mini-maglev/electrical/LTspice/motor-phase.asc

L1: ind; 0.008
R1: res; 3
V1: voltage; PWL file=pwm_sine_wave.txt
Named nets: 0
.tran 0 0.1 0 0.000001
