mini-maglev/electrical/LTspice/driver-inverter-motor.asc

AMP1_pwm_rejection: UniversalOpAmp
AMP2_pwm_rejection: UniversalOpAmp
AMP3_cheap: UniversalOpAmp
CURRENT_SENSE_AMPLIFIER_SUPPLY_?: voltage
INVERTER_SUPPLY: voltage
M1: nmos
M2: nmos
M3: nmos
M4: nmos
M5: nmos
M6: nmos
MCU_SUPPLY: voltage
R1: res
R1_small_gate_resistor_?: res
R2: res
R2_small_gate_resistor_?: res
R3: res
R4: res
R_SENSE_A1: res
R_SENSE_A: res
R_SENSE_LOW_SIDE: res
Named nets: PHASE_A_HIGH, PHASE_A_LOW, STATOR_PHASE_A, 0, PHASE_B_HIGH, PHASE_B_LOW, STATOR_PHASE_B, PHASE_C_HIGH, PHASE_C_LOW, STATOR_PHASE_C
