mini-maglev/electrical/motor_driver/motor_driver.kicad_pcb

## KiCad design motor_driver/motor_driver.kicad_pcb (2025-03-02)

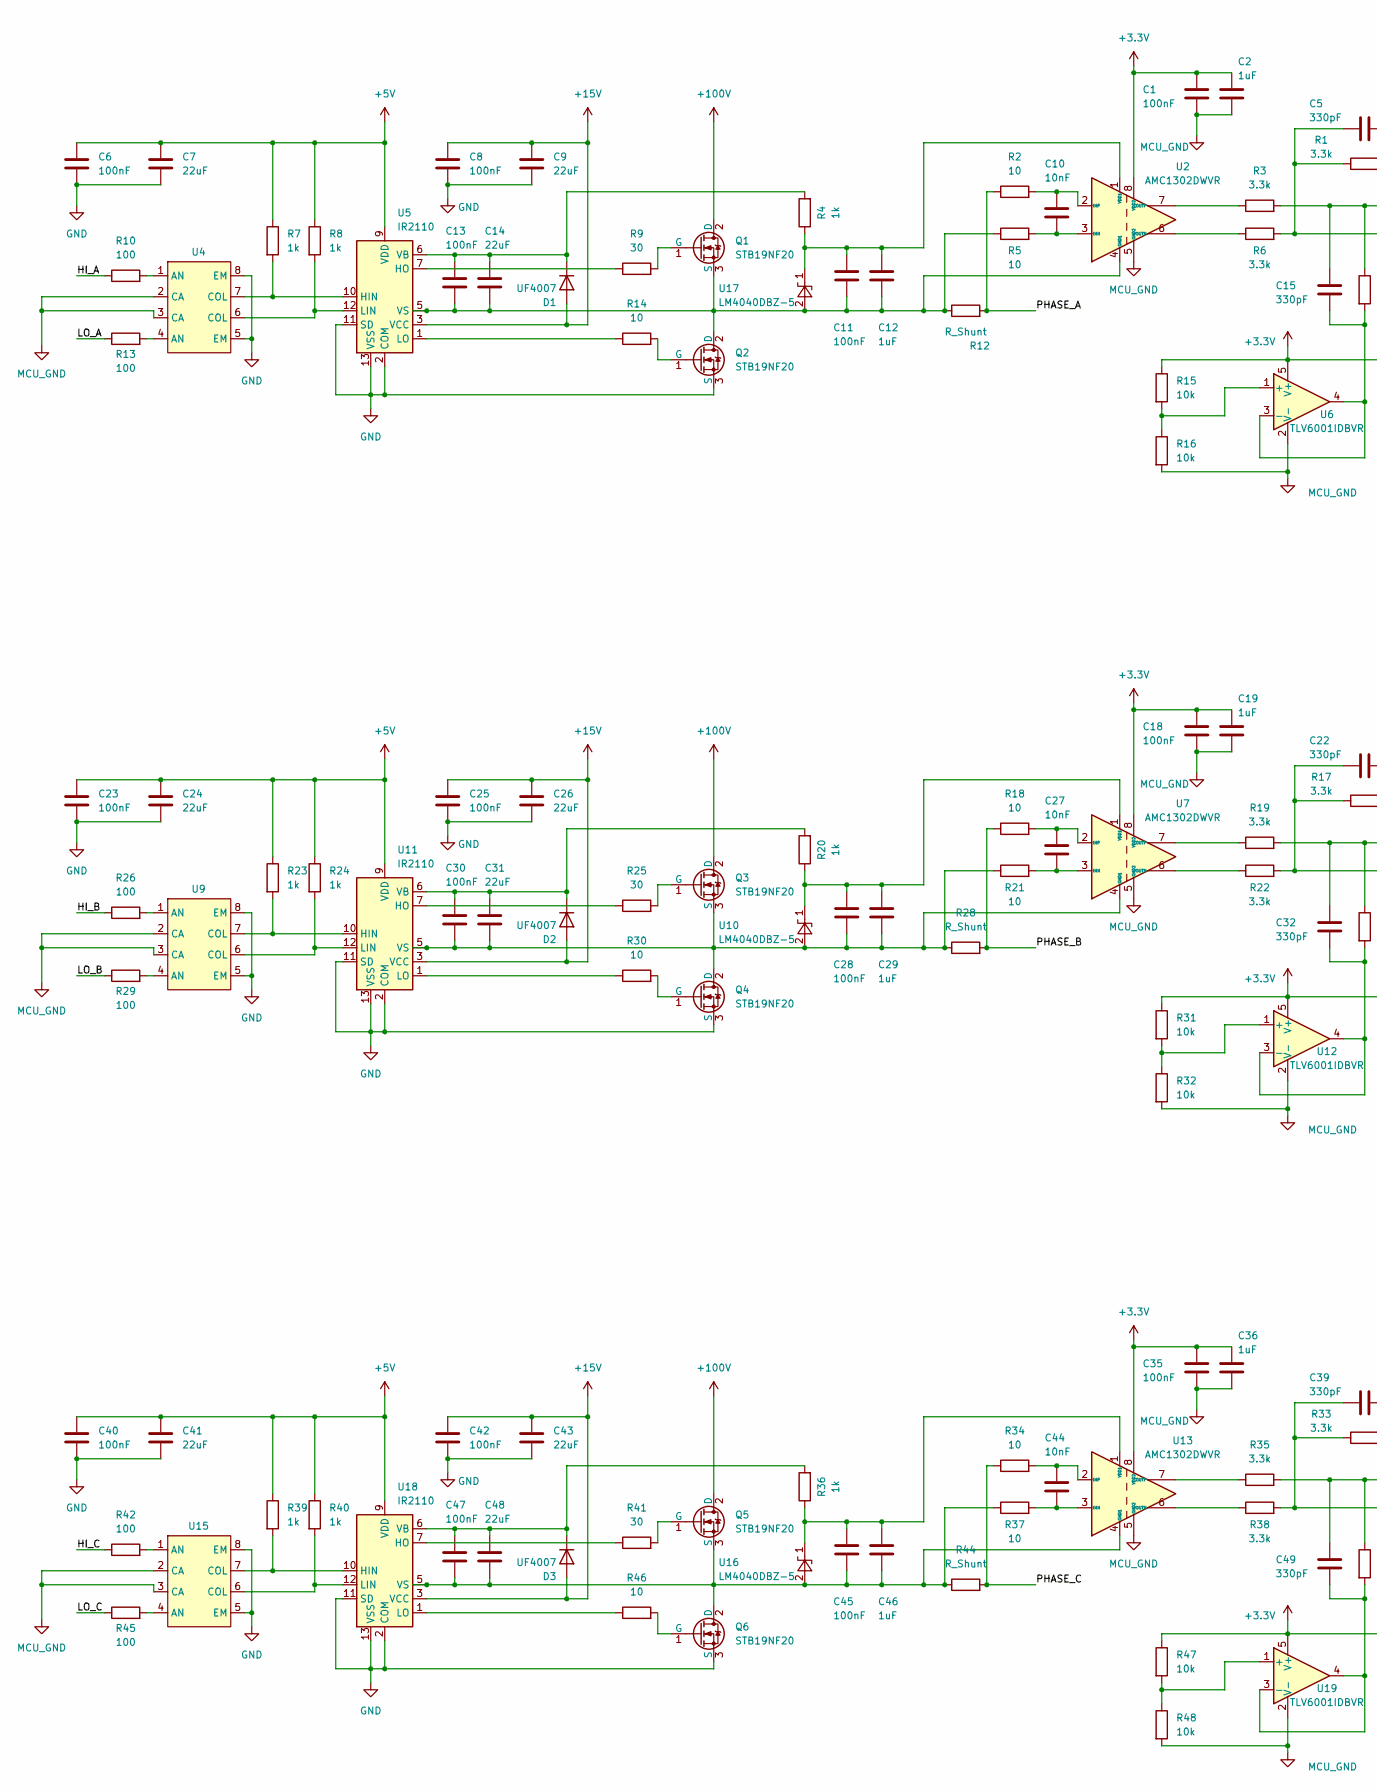
[picture p1: schematic motor_driver.kicad_sch, part in row 1, column 1]

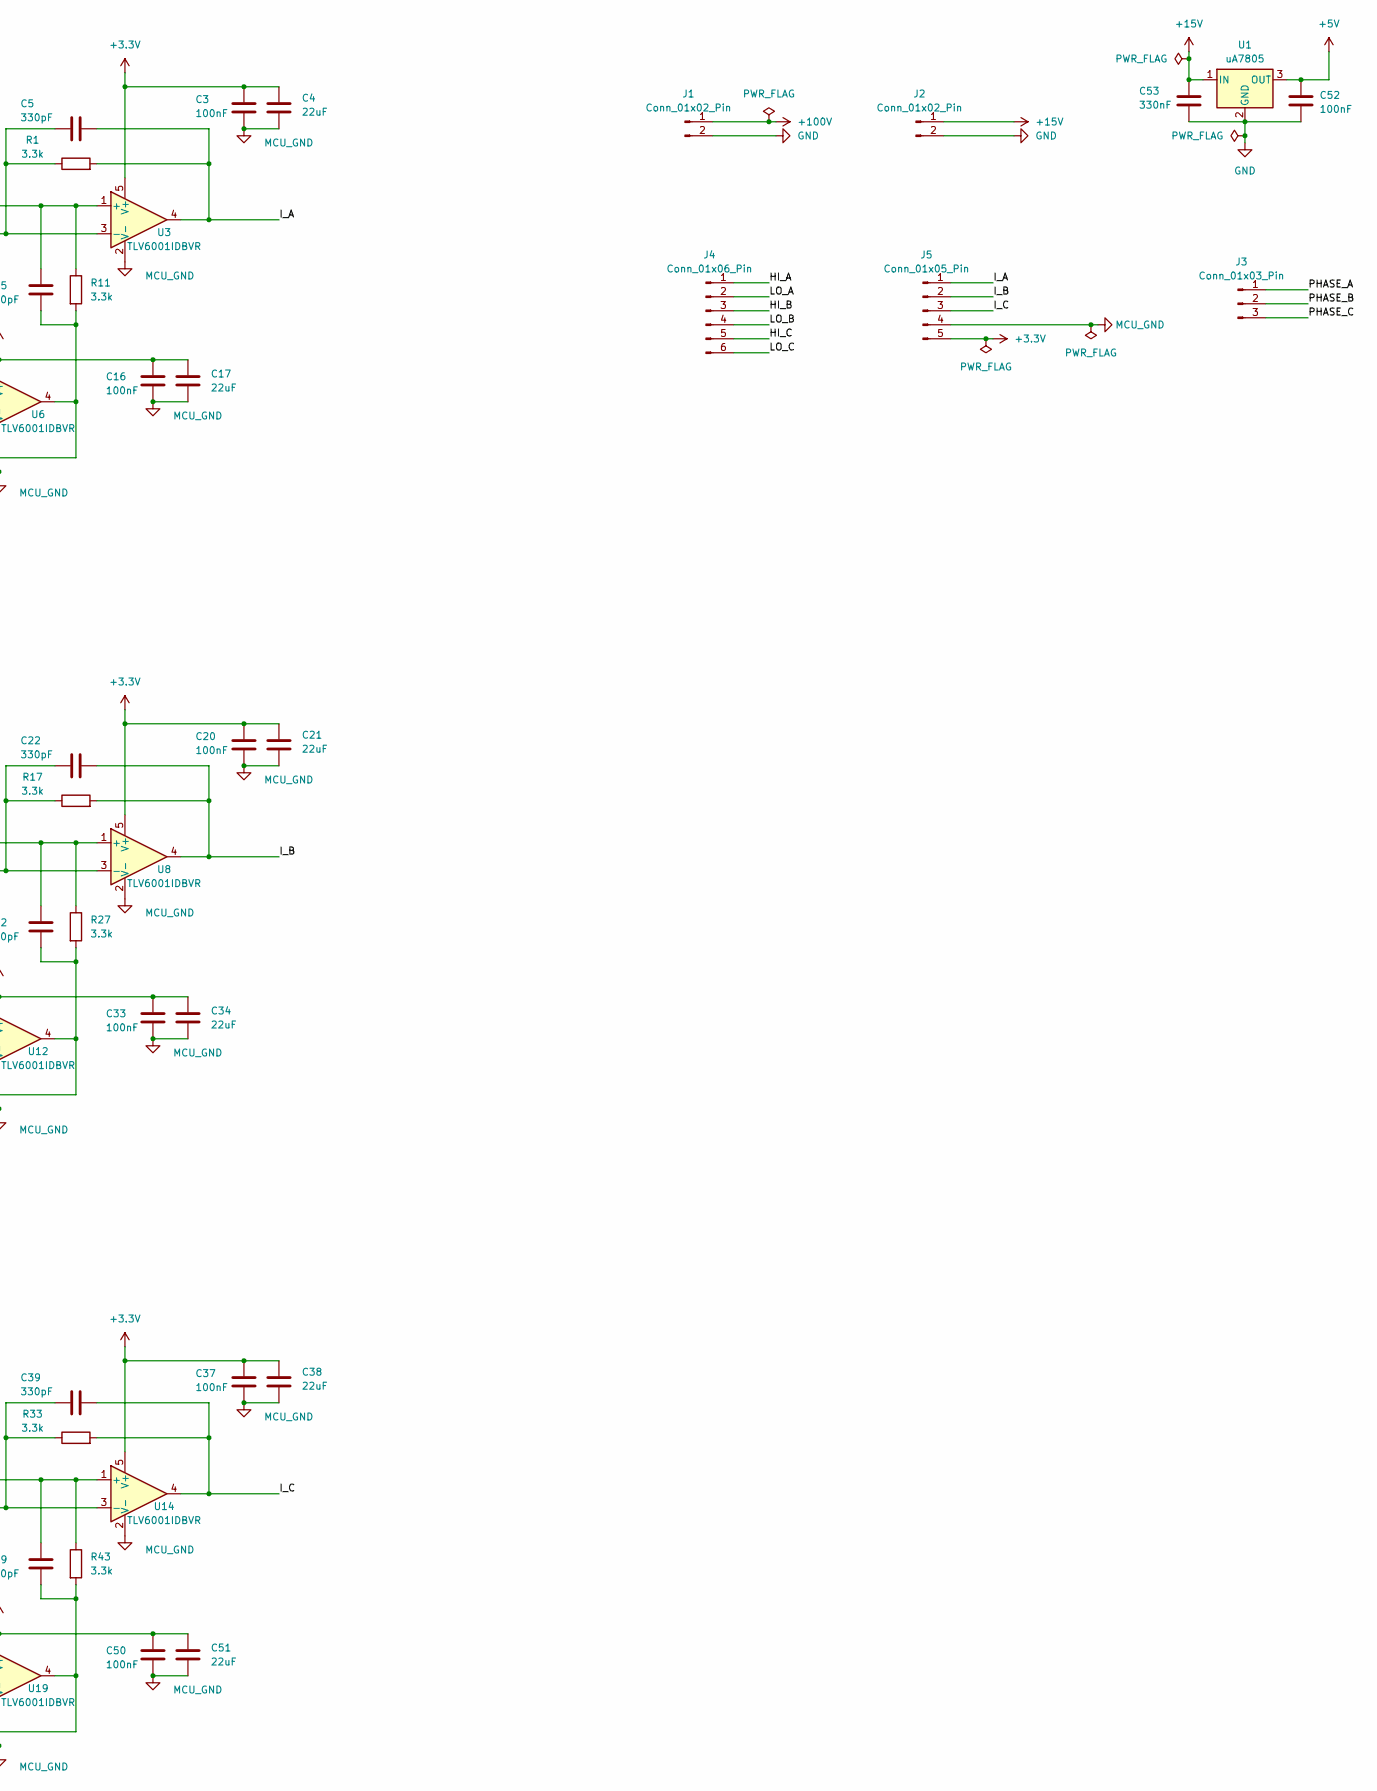
[picture p2: schematic motor_driver.kicad_sch, part in row 1, column 2]

Parts:
C1, C3, C6, C8, C11, C13, C16, C18, C20, C23, C25, C28, C30, C33, C35, C37, C40, C42, C45, C47, C50, C52: 100nF; C_0603_1608Metric_Pad1.08x0.95mm_HandSolder
C2, C12, C19, C29, C36, C46: 1uF; C_0805_2012Metric_Pad1.18x1.45mm_HandSolder
C4, C7, C9, C14, C17, C21, C24, C26, C31, C34, C38, C41, C43, C48, C51: 22uF; C_0805_2012Metric_Pad1.18x1.45mm_HandSolder
C5, C15, C22, C32, C39, C49: 330pF; C_0402_1005Metric_Pad0.74x0.62mm_HandSolder
C10, C27, C44: 10nF; C_0402_1005Metric_Pad0.74x0.62mm_HandSolder
C53: 330nF; C_0805_2012Metric_Pad1.18x1.45mm_HandSolder
D1, D2, D3: UF4007; D_DO-41_SOD81_P10.16mm_Horizontal
J1: Conn_01x02_Pin; TerminalBlock_MetzConnect_Type067_RT01902HDWC_1x02_P10.00mm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
J2: Conn_01x02_Pin; TerminalBlock_MaiXu_MX126-5.0-02P_1x02_P5.00mm
J3: Conn_01x03_Pin; TerminalBlock_MetzConnect_Type067_RT01903HDWC_1x03_P10.00mm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
J4: Conn_01x06_Pin; PinHeader_1x06_P2.54mm_Vertical
J5: Conn_01x05_Pin; PinHeader_1x05_P2.54mm_Vertical
Q1, Q2, Q3, Q4, Q5, Q6: STB19NF20; TO-220-3_Vertical_Heat_Sink
R1, R3, R6, R11, R17, R19, R22, R27, R33, R35, R38, R43: 3.3k; R_0805_2012Metric_Pad1.20x1.40mm_HandSolder
R2, R5, R14, R18, R21, R30, R34, R37, R46: 10; R_1206_3216Metric_Pad1.30x1.75mm_HandSolder
R4, R20, R36: 1k; R_1206_3216Metric_Pad1.30x1.75mm_HandSolder
R7, R8, R23, R24, R39, R40: 1k; R_0805_2012Metric_Pad1.20x1.40mm_HandSolder
R9, R25, R41: 30; R_1206_3216Metric_Pad1.30x1.75mm_HandSolder
R10, R13, R26, R29, R42, R45: 100; R_0805_2012Metric_Pad1.20x1.40mm_HandSolder
R12, R44: R_Shunt; BVT-I-R003
R15, R16, R31, R32, R47, R48: 10k; R_0805_2012Metric_Pad1.20x1.40mm_HandSolder
R28: R_Shunt; BVT-I-R003_Reverse
U1: uA7805; TO-220-3_Vertical
U2, U7, U13: AMC1302DWVR; SOIC-8_7.5x5.85mm_P1.27mm
U3, U6, U8, U12, U14, U19: TLV6001IDBVR; SOT-23-5_HandSoldering
U4, U9, U15: MCT6
U5, U11, U18: IR2110; DIP-14_W7.62mm
U10, U16, U17: LM4040DBZ-5; SOT-23

Connections:
+3.3V: C1.1, C2.1, C3.1, C4.1, C16.1, C17.1, C18.1, C19.1, C20.1, C21.1, C33.1, C34.1, C35.1, C36.1, C37.1, C38.1, C50.1, C51.1, J5.5, R15.1, R31.1, R47.1, U2.8 (VDD2), U3.5 (V+), U6.5 (V+), U7.8 (VDD2), U8.5 (V+), U12.5 (V+), U13.8 (VDD2), U14.5 (V+), U19.5 (V+)
+5V: C6.1, C7.1, C23.1, C24.1, C40.1, C41.1, C52.1, R7.1, R8.1, R23.1, R24.1, R39.1, R40.1, U1.3 (OUT), U5.9 (VDD), U11.9 (VDD), U18.9 (VDD)
+15V: C8.1, C9.1, C25.1, C26.1, C42.1, C43.1, C53.1, D1.2 (A), D2.2 (A), D3.2 (A), J2.1, U1.1 (IN), U5.3 (VCC), U11.3 (VCC), U18.3 (VCC)
+100V: J1.1, Q1.2 (D), Q3.2 (D), Q5.2 (D)
/HI_A: J4.1, R10.1
/HI_B: J4.3, R26.1
/HI_C: J4.5, R42.1
/I_A: C5.1, J5.1, R1.2, U3.4
/I_B: C22.1, J5.2, R17.2, U8.4
/I_C: C39.1, J5.3, R33.2, U14.4
/LO_A: J4.2, R13.1
/LO_B: J4.4, R29.1
/LO_C: J4.6, R45.1
/PHASE_A: J3.1, R2.1, R12.2
/PHASE_B: J3.2, R18.1, R28.2
/PHASE_C: J3.3, R34.1, R44.2
GND: C6.2, C7.2, C8.2, C9.2, C23.2, C24.2, C25.2, C26.2, C40.2, C41.2, C42.2, C43.2, C52.2, C53.2, J1.2, J2.2, Q2.3 (S), Q4.3 (S), Q6.3 (S), U1.2 (GND), U4.5 (EM), U4.8 (EM), U5.2 (COM), U5.11 (SD), U5.13 (VSS), U9.5 (EM), U9.8 (EM), U11.2 (COM), U11.11 (SD), U11.13 (VSS), U15.5 (EM), U15.8 (EM), U18.2 (COM), U18.11 (SD), U18.13 (VSS)
MCU_GND: C1.2, C2.2, C3.2, C4.2, C16.2, C17.2, C18.2, C19.2, C20.2, C21.2, C33.2, C34.2, C35.2, C36.2, C37.2, C38.2, C50.2, C51.2, J5.4, R16.2, R32.2, R48.2, U2.5 (GND2), U3.2 (V-), U4.2 (CA), U4.3 (CA), U6.2 (V-), U7.5 (GND2), U8.2 (V-), U9.2 (CA), U9.3 (CA), U12.2 (V-), U13.5 (GND2), U14.2 (V-), U15.2 (CA), U15.3 (CA), U19.2 (V-)
unnamed: C13.1, C14.1, D1.1 (K), R4.2, U5.6 (VB)
unnamed: C30.1, C31.1, D2.1 (K), R20.2, U11.6 (VB)
unnamed: C47.1, C48.1, D3.1 (K), R36.2, U18.6 (VB)
unnamed: Q1.1 (G), R9.2
unnamed: C11.2, C12.2, C13.2, C14.2, Q1.3 (S), Q2.2 (D), R5.1, R12.1, U2.4 (GND1), U5.5 (VS), U17.2 (A)
unnamed: Q2.1 (G), R14.2
unnamed: Q3.1 (G), R25.2
unnamed: C28.2, C29.2, C30.2, C31.2, Q3.3 (S), Q4.2 (D), R21.1, R28.1, U7.4 (GND1), U10.2 (A), U11.5 (VS)
unnamed: Q4.1 (G), R30.2
unnamed: Q5.1 (G), R41.2
unnamed: C45.2, C46.2, C47.2, C48.2, Q5.3 (S), Q6.2 (D), R37.1, R44.1, U13.4 (GND1), U16.2 (A), U18.5 (VS)
unnamed: Q6.1 (G), R46.2
unnamed: R10.2, U4.1 (AN)
unnamed: R13.2, U4.4 (AN)
unnamed: R26.2, U9.1 (AN)
unnamed: R29.2, U9.4 (AN)
unnamed: R42.2, U15.1 (AN)
unnamed: R45.2, U15.4 (AN)
unnamed: C10.2, R5.2, U2.3 (INN)
unnamed: C10.1, R2.2, U2.2 (INP)
unnamed: R6.1, U2.6 (OUTN)
unnamed: R3.1, U2.7 (OUTP)
unnamed: C15.1, R3.2, R11.1, U3.1 (+)
unnamed: C5.2, R1.1, R6.2, U3.3 (-)
unnamed: R7.2, U4.7 (COL), U5.10 (HIN)
unnamed: R9.1, U5.7 (HO)
unnamed: R8.2, U4.6 (COL), U5.12 (LIN)
unnamed: R14.1, U5.1 (LO)
unnamed: R15.2, R16.1, U6.1 (+)
unnamed: C15.2, R11.2, U6.3 (-), U6.4
unnamed: C27.2, R21.2, U7.3 (INN)
unnamed: C27.1, R18.2, U7.2 (INP)
unnamed: R22.1, U7.6 (OUTN)
unnamed: R19.1, U7.7 (OUTP)
unnamed: C32.1, R19.2, R27.1, U8.1 (+)
unnamed: C22.2, R17.1, R22.2, U8.3 (-)
unnamed: C28.1, C29.1, R20.1, U7.1 (VDD1), U10.1 (K)
unnamed: R23.2, U9.7 (COL), U11.10 (HIN)
unnamed: R25.1, U11.7 (HO)
unnamed: R24.2, U9.6 (COL), U11.12 (LIN)
unnamed: R30.1, U11.1 (LO)
unnamed: R31.2, R32.1, U12.1 (+)
unnamed: C32.2, R27.2, U12.3 (-), U12.4
unnamed: C44.2, R37.2, U13.3 (INN)
unnamed: C44.1, R34.2, U13.2 (INP)
unnamed: R38.1, U13.6 (OUTN)
unnamed: R35.1, U13.7 (OUTP)
unnamed: C45.1, C46.1, R36.1, U13.1 (VDD1), U16.1 (K)
unnamed: C49.1, R35.2, R43.1, U14.1 (+)
unnamed: C39.2, R33.1, R38.2, U14.3 (-)
unnamed: C11.1, C12.1, R4.1, U2.1 (VDD1), U17.1 (K)
unnamed: R39.2, U15.7 (COL), U18.10 (HIN)
unnamed: R41.1, U18.7 (HO)
unnamed: R40.2, U15.6 (COL), U18.12 (LIN)
unnamed: R46.1, U18.1 (LO)
unnamed: R47.2, R48.1, U19.1 (+)
unnamed: C49.2, R43.2, U19.3 (-), U19.4

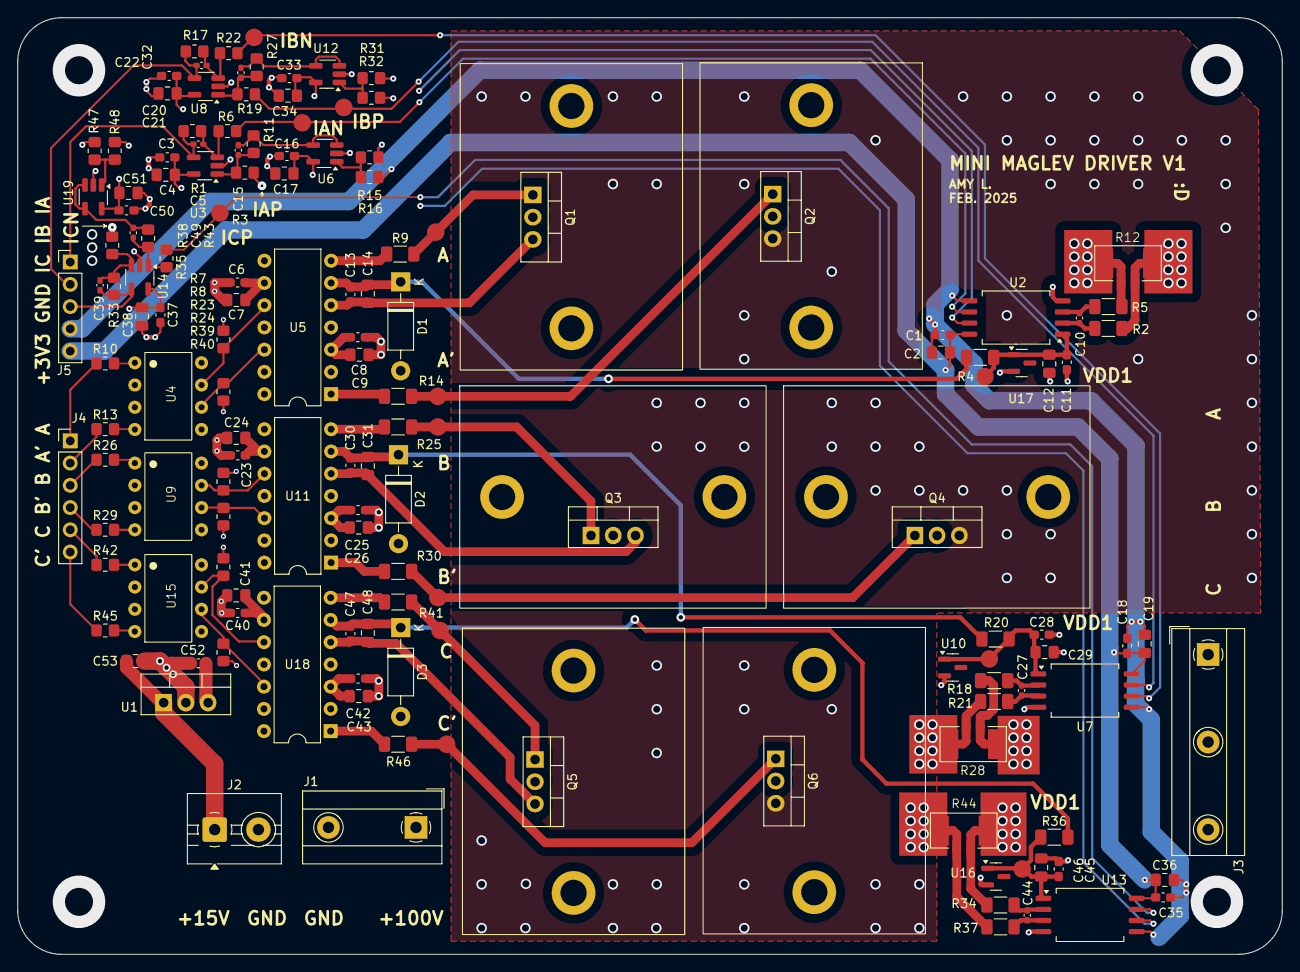
[picture p3: board motor_driver.kicad_pcb from above]

Board: 4 copper layers, 144.5 x 107.0 mm, 134 parts (0 on the bottom side), 75 nets.
