mini-maglev/electrical/(commit log)

2025-01-14 Current ripple simulation
2025-02-04 Test circuit schematics
    [test_circuits.kicad_pcb, test_circuits.kicad_sch]
2025-02-23 Driver schematic
    [motor_driver.kicad_pcb, motor_driver.kicad_sch]
2025-02-24 Change to isolation amp
    [motor_driver.kicad_sch]
2025-02-24 Add footprints
    [motor_driver.kicad_pcb, motor_driver.kicad_sch]
2025-02-28 Minor component changes
    [motor_driver.kicad_pcb, motor_driver.kicad_sch]
2025-03-02 Almost done
    [motor_driver.kicad_pcb, motor_driver.kicad_sch]
2025-03-02 Add 3d models
    [motor_driver-B_Cu.gbr, motor_driver-B_Mask.gbr, motor_driver-B_Paste.gbr, motor_driver-B_Silkscreen.gbr, motor_driver-Edge_Cuts.gbr, motor_driver-F_Cu.gbr, motor_driver-F_Mask.gbr, motor_driver-F_Paste.gbr]
2025-03-02 Change test points from paste to mask layer as the should be
    [motor_driver-B_Cu.gbr, motor_driver-B_Mask.gbr, motor_driver-B_Paste.gbr, motor_driver-B_Silkscreen.gbr, motor_driver-Edge_Cuts.gbr, motor_driver-F_Cu.gbr, motor_driver-F_Mask.gbr, motor_driver-F_Paste.gbr]
2025-03-02 Minor formatting change
    [motor_driver-B_Cu.gbr, motor_driver-B_Mask.gbr, motor_driver-B_Paste.gbr, motor_driver-B_Silkscreen.gbr, motor_driver-Edge_Cuts.gbr, motor_driver-F_Cu.gbr, motor_driver-F_Mask.gbr, motor_driver-F_Paste.gbr]
